brijohn/pimodem/kicad/piHAT/pimodem.kicad_pcb

## KiCad design kicad/piHAT/pimodem.kicad_pcb (2020-12-14)

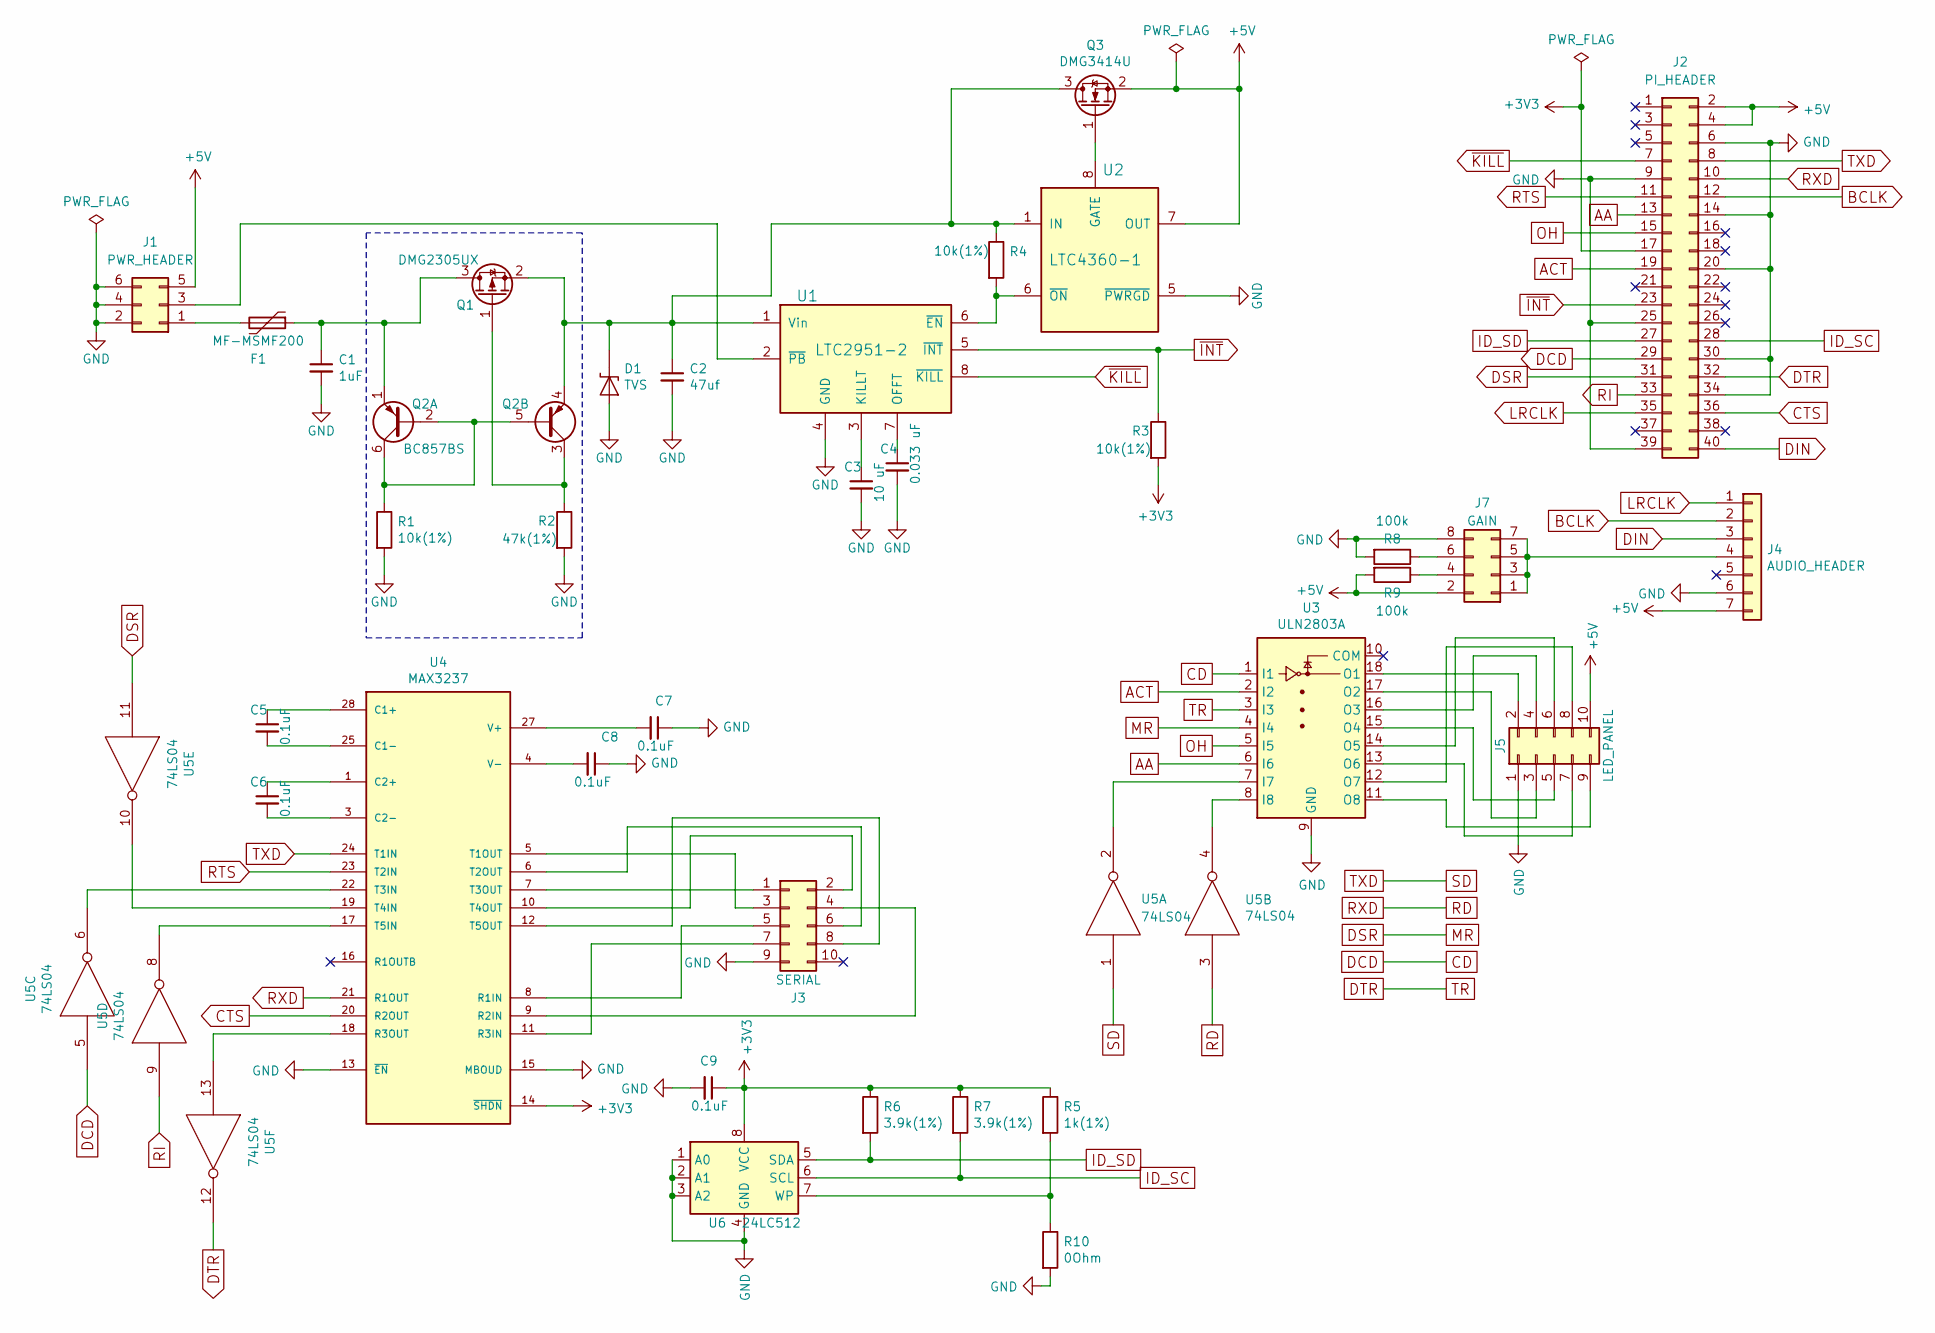
[picture p1: schematic pimodem.sch]

Parts:
C1: 1uF; C_0805_2012Metric; Digikey 478-1405-1-ND
C2: 47uf; C_0805_2012Metric; Digikey 445-8239-1-ND
C3: 10 uF; C_0805_2012Metric; Digikey 399-4925-1-ND
C4: 0.033 uF; C_0805_2012Metric; Digikey 732-8024-1-ND
C5: 0.1uF; C_0805_2012Metric; Digikey 399-7999-1-ND
C6, C7, C8, C9: 0.1uF; C_0805_2012Metric
D1: TVS; D_SMB; Digikey SMBJ5.0ALFCT-ND
F1: MF-MSMF200; R_1812_4532Metric; Digikey MF-MSMF200-2CT-ND
J1: PWR_HEADER; Molex_Micro-Fit_3.0_43045-0612_2x03_P3.00mm_Vertical; Digikey WM10679-ND
J2: PI_HEADER; PinSocket_2x20_P2.54mm_Vertical; Digikey S9200-ND
J3: SERIAL; PinHeader_2x05_P2.54mm_Vertical; Digikey 609-3243-ND
J4: AUDIO_HEADER; MAX98357_I2S_DAC; Digikey A31117-ND
J5: LED_PANEL; PinHeader_2x05_P2.54mm_Vertical; Digikey 609-3243-ND
J7: GAIN; PinHeader_2x04_P2.54mm_Vertical; Digikey 609-3391-ND
Q1: DMG2305UX; SOT-23; Digikey DMG2305UX-13DICT-ND
Q2: BC857BS; SOT-363_SC-70-6; Digikey BC857BS-7FDICT-ND
Q3: DMG3414U; SOT-23; Digikey DMG3414U-7DICT-ND
R1: 10k(1%); R_0805_2012Metric; Digikey 311-10.0KCRCT-ND
R2: 47k(1%); R_0805_2012Metric; Digikey 311-47.0KCRCT-ND
R3, R4: 10k(1%); R_0805_2012Metric
R5: 1k(1%); R_0805_2012Metric; Digikey 311-1.00KCRCT-ND
R6: 3.9k(1%); R_0805_2012Metric; Digikey RMCF0805FT3K90CT-ND
R7: 3.9k(1%); R_0805_2012Metric
R8: 100k; R_0805_2012Metric; Digikey 311-100KCRCT-ND
R9: 100k; R_0805_2012Metric
R10: 0Ohm; R_0805_2012Metric; Digikey 311-0.0ARCT-ND
U1: LTC2951-2; SOT-23-8; Digikey LTC2951CTS8-2#TRMPBFCT-ND
U2: LTC4360-1; SC-70-8; Digikey LTC4360ISC8-1#TRMPBFCT-ND
U3: ULN2803A; SOIC-18W_7.5x11.6mm_P1.27mm; Digikey 296-15777-1-ND
U4: MAX3237; SSOP-28_5.3x10.2mm_P0.65mm; Digikey MAX3237EAI+-ND
U5: 74LS04; SOIC-14_3.9x8.7mm_P1.27mm; Digikey 296-14875-1-ND
U6: 24LC512; SOIC-8_3.9x4.9mm_P1.27mm; Digikey CAT24C512WI-GT3OSCT-ND

Connections:
+3V3: C9.1, J2.17, R3.2, R5.1, R6.1, R7.1, U4.14 (~SHDN~), U4.26 (+3V3), U6.8 (VCC)
+5V: J1.5, J2.2, J2.4, J4.7, J5.10, J7.2, Q3.2 (S), R9.2, U2.7 (OUT), U5.14 (+5V)
AA: J2.13, U3.6 (I6)
ACT: J2.19, U3.2 (I2)
BCLK: J2.12, J4.2
CD: J2.29, U3.1 (I1), U5.5
CTS: J2.36, U4.20 (R2OUT)
DIN: J2.40, J4.3
DSR: J2.31, U3.4 (I4), U5.11
DTR: J2.32, U3.3 (I3), U5.12
GND: C1.2, C2.2, C3.2, C4.2, C7.1, C8.1, C9.2, D1.2 (A2), J1.2, J1.4, J1.6, J2.6, J2.9, J2.14, J2.20, J2.25, J2.30, J2.34, J2.39, J3.9, J4.6, J5.1, J7.8, R1.2, R2.2, R8.2, R10.2, U1.4 (GND), U2.2 (GND), U2.3 (GND), U2.4 (GND), U2.5 (~PWRGD~), U3.9 (GND), U4.2 (GND), U4.13 (~EN~), U4.15 (MBOUD), U5.7 (GND), U6.1 (A0), U6.2 (A1), U6.3 (A2), U6.4 (GND)
ID_SC: J2.28, R7.2, U6.6 (SCL)
ID_SD: J2.27, R6.2, U6.5 (SDA)
LRCLK: J2.35, J4.1
unnamed: C1.1, F1.1, Q1.3 (D), Q2.1 (E1)
unnamed: C2.1, D1.1 (A1), Q1.2 (S), Q2.4 (E2), Q3.3 (D), R4.1, U1.1 (Vin), U2.1 (IN)
unnamed: C3.1, U1.3 (KILLT)
unnamed: C4.1, U1.7 (OFFT)
unnamed: C5.1, U4.28 (C1+)
unnamed: C5.2, U4.25 (C1-)
unnamed: C6.1, U4.1 (C2+)
unnamed: C6.2, U4.3 (C2-)
unnamed: C7.2, U4.27 (V+)
unnamed: C8.2, U4.4 (V-)
unnamed: F1.2, J1.1
unnamed: J1.3, U1.2 (~PB~)
unnamed: J3.1, U4.7 (T3OUT)
unnamed: J3.2, U4.10 (T4OUT)
unnamed: J3.3, U4.5 (T1OUT)
unnamed: J3.4, U4.9 (R2IN)
unnamed: J3.5, U4.8 (R1IN)
unnamed: J3.6, U4.6 (T2OUT)
unnamed: J3.7, U4.11 (R3IN)
unnamed: J3.8, U4.12 (T5OUT)
unnamed: J4.4, J7.1, J7.3, J7.5, J7.7
unnamed: J5.2, U3.18 (O1)
unnamed: J5.3, U3.17 (O2)
unnamed: J5.4, U3.16 (O3)
unnamed: J5.5, U3.15 (O4)
unnamed: J5.6, U3.14 (O5)
unnamed: J5.7, U3.13 (O6)
unnamed: J5.8, U3.12 (O7)
unnamed: J5.9, U3.11 (O8)
unnamed: J7.4, R9.1
unnamed: J7.6, R8.1
unnamed: Q1.1 (G), Q2.3 (C2), R2.1
unnamed: Q2.2 (B1), Q2.5 (B2), Q2.6 (C1), R1.1
unnamed: Q3.1 (G), U2.8 (GATE)
unnamed: R4.2, U1.6 (~EN~), U2.6 (~ON~)
unnamed: R5.2, R10.1, U6.7 (WP)
unnamed: U3.7 (I7), U5.2
unnamed: U3.8 (I8), U5.4
unnamed: U4.17 (T5IN), U5.8
unnamed: U4.18 (R3OUT), U5.13
unnamed: U4.19 (T4IN), U5.10
unnamed: U4.22 (T3IN), U5.6
OH: J2.15, U3.5 (I5)
RD: J2.10, U4.21 (R1OUT), U5.3
RI: J2.33, U5.9
RTS: J2.11, U4.23 (T2IN)
SD: J2.8, U4.24 (T1IN), U5.1
~INT~: J2.23, R3.1, U1.5 (~INT~)
~KILL~: J2.7, U1.8 (~KILL~)

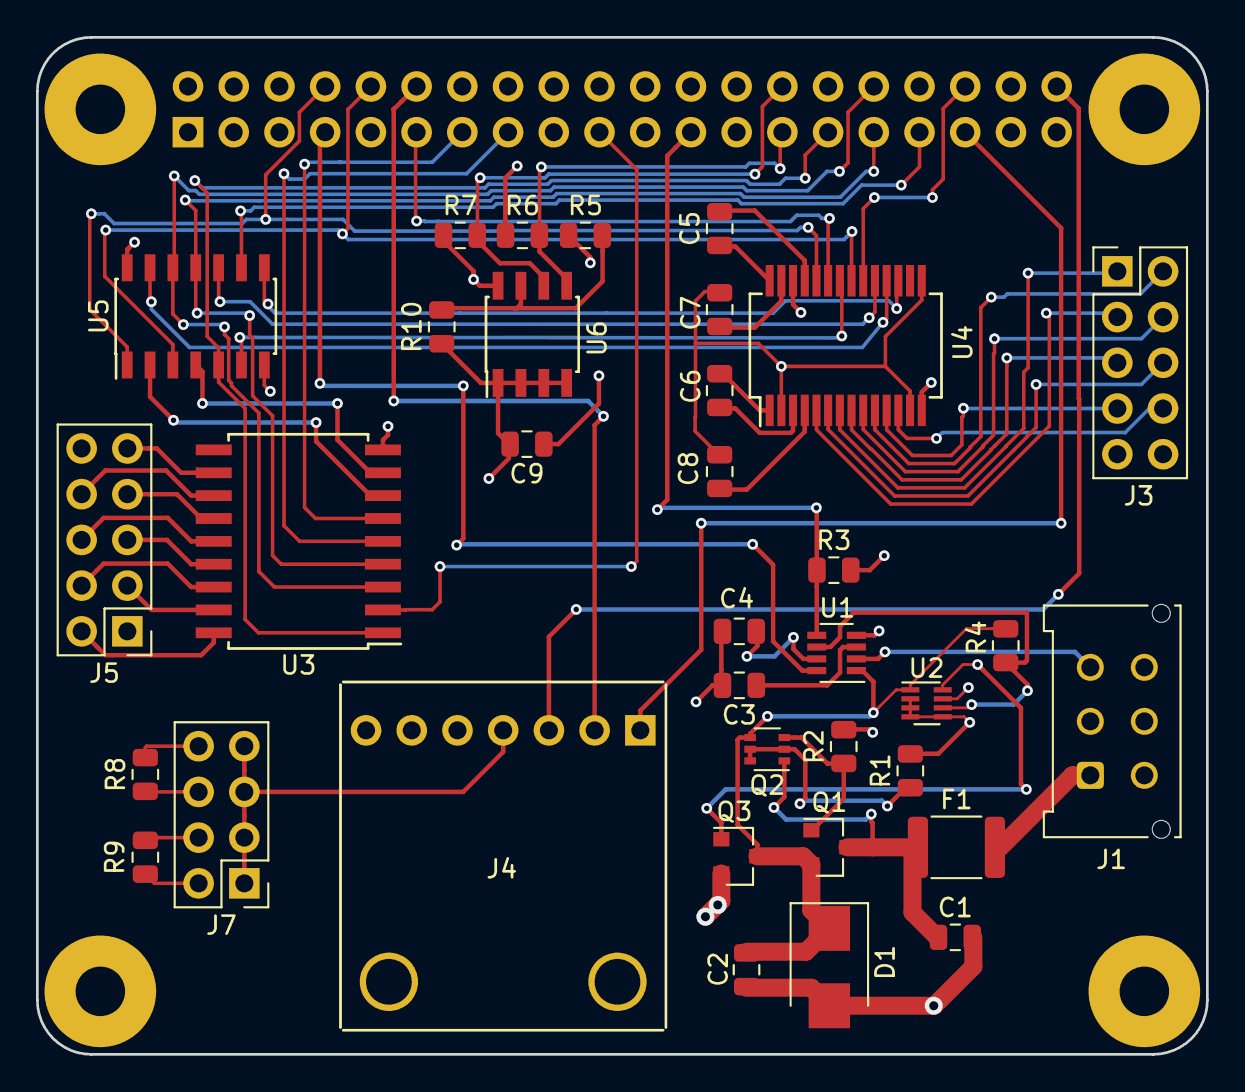
[picture p2: board pimodem.kicad_pcb from above]

Board: 4 copper layers, 65.0 x 56.5 mm, 36 parts (1 on the bottom side), 63 nets.
