brijohn/pimodem/kicad/led_board/led_board.kicad_pcb

## KiCad design kicad/led_board/led_board.kicad_pcb (2020-12-14)

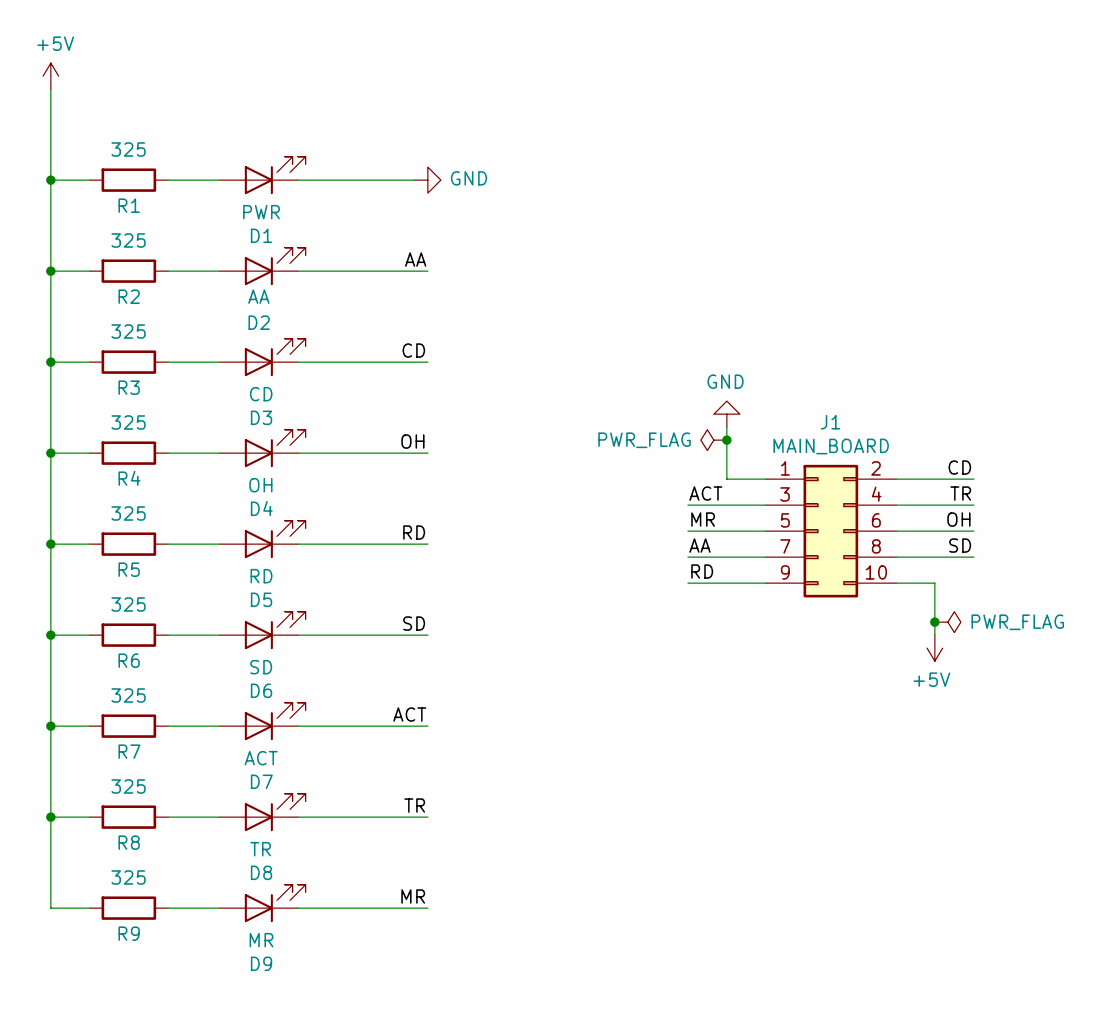
[picture p3: schematic led_board.sch, PiModem - LED board]

Parts:
D1: PWR; LED_D5.0mm
D2: AA; LED_D5.0mm
D3: CD; LED_D5.0mm
D4: OH; LED_D5.0mm
D5: RD; LED_D5.0mm
D6: SD; LED_D5.0mm
D7: ACT; LED_D5.0mm
D8: TR; LED_D5.0mm
D9: MR; LED_D5.0mm
J1: MAIN_BOARD; PinHeader_2x05_P2.54mm_Vertical
R1, R2, R3, R4, R5, R6, R7, R8, R9: 325; R_Axial_DIN0207_L6.3mm_D2.5mm_P10.16mm_Horizontal

Connections:
+5V: J1.10, R1.2, R2.2, R3.2, R4.2, R5.2, R6.2, R7.2, R8.2, R9.2
/AA: D2.1 (K), J1.7
/ACT: D7.1 (K), J1.3
/CD: D3.1 (K), J1.2
/MR: D9.1 (K), J1.5
/OH: D4.1 (K), J1.6
/RD: D5.1 (K), J1.9
/SD: D6.1 (K), J1.8
/TR: D8.1 (K), J1.4
GND: D1.1 (K), J1.1
unnamed: D1.2 (A), R1.1
unnamed: D2.2 (A), R2.1
unnamed: D3.2 (A), R3.1
unnamed: D4.2 (A), R4.1
unnamed: D5.2 (A), R5.1
unnamed: D6.2 (A), R6.1
unnamed: D7.2 (A), R7.1
unnamed: D8.2 (A), R8.1
unnamed: D9.2 (A), R9.1

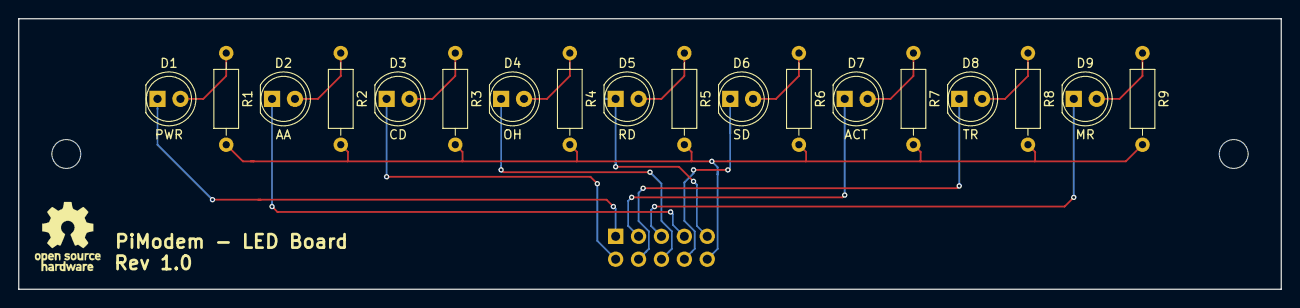
[picture p4: board led_board.kicad_pcb from above]

Board: 2 copper layers, 140.0 x 30.0 mm, 19 parts (1 on the bottom side), 19 nets.
