brijohn/pimodem/eeprom/nvmem.yaml

at24c512:
  device: "3-00500"
  offset: 8192
  size: 57344
  cells:
    passwd:
      offset: 0
      len: 106
      type: "string"
    ip:
      offset: 106
      len: 4
      type: "ipv4"
    netmask:
      offset: 110
      len: 4
      type: "ipv4"
    gateway:
      offset: 114
      len: 4
      type: "ipv4"
    dns:
      offset: 118
      len: 4
      type: "ipv4"
    baud:
      offset: 122
      len: 2
      type: "uint16"
    profile0:
      offset: 512
      len: 256
      type: "bytes"
    profile1:
      offset: 768
      len: 256
      type: "bytes"
    powerup:
      offset: 1024
      len: 2
      type: "uint16"
