brijohn/pimodem/(commit log)

2017-09-06 Add kicad schematic and pcb files
    [pimodem.kicad_pcb, pimodem.sch]
2018-06-17 Update kicad schematic to latest version of kicad nightly
    [pimodem.kicad_pcb, pimodem.sch]
2018-06-18 small update to kicad custom parts
2019-05-18 Update traces for serial header to use DTK/intel format
    [pimodem.kicad_pcb, pimodem.sch]
2019-06-10 Issue halt syscall when shutdown pin is pulled low
2019-06-15 Add i2c driver to device tree eeprom blob
2019-06-15 eeprom: Add shutdown pin to pins.yaml
2019-06-15 kicad: update schematic to use 128kbit eeprom
    [pimodem.sch]
2019-06-20 eeprom: add network activity LED
2020-04-05 kicad: Update schematic and pcb layout
    * Connect serial gpio signals through inverter gates
    * Connect all leds to gpio pins
    * Update eeprom to 24c512
    * Update pcb footprints to new names (kicad update)
    * Update schematic/board revision to 1.2
    [pimodem.kicad_pcb, pimodem.sch]
2020-04-14 pimodem: add on write callbacks to registers (use for setting dcd led status)
2020-04-16 pimodem: Add 'AA' led support
2020-12-03 kicad: Add LED front panel board
    [led_board.kicad_pcb, led_board.sch, pimodem.kicad_pcb, pimodem.sch]
2020-12-14 kicad: add copyright and license to kicad documents
    [led_board.kicad_pcb, led_board.sch, pimodem.kicad_pcb, pimodem.sch]
