brijohn/pimodem/(notices)

Notices in the files:
kicad/led_board/led_board.kicad_pcb:
License: GPLv2
Copyright (c) 2019-2020
kicad/piHAT/pimodem.kicad_pcb:
Copyright (c) 2017-2020
